axg20202/CNC-parts-and-mods/Docking dust shoe/STL/Left side mount/Main body left.stl

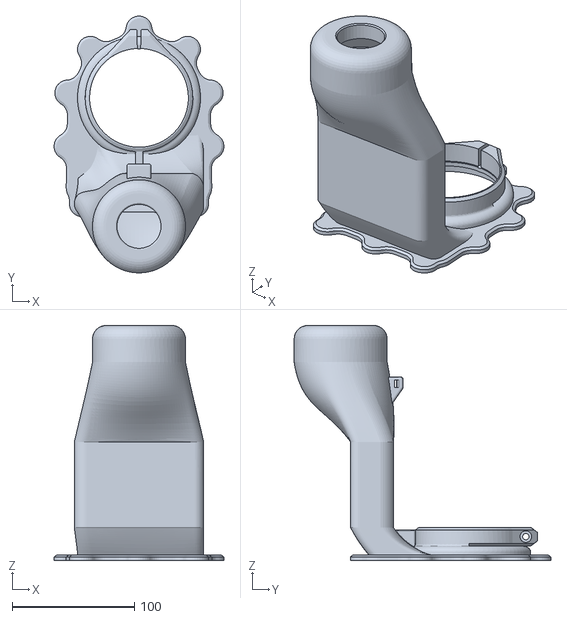
[picture p4: CAD file, 2025-01-09]
Docking dust shoe/STL/Left side mount/Main body left.stl
138.8 x 209.7 x 192.0
