axg20202/CNC-parts-and-mods/Docking dust shoe/STL/Bristle ring.stl

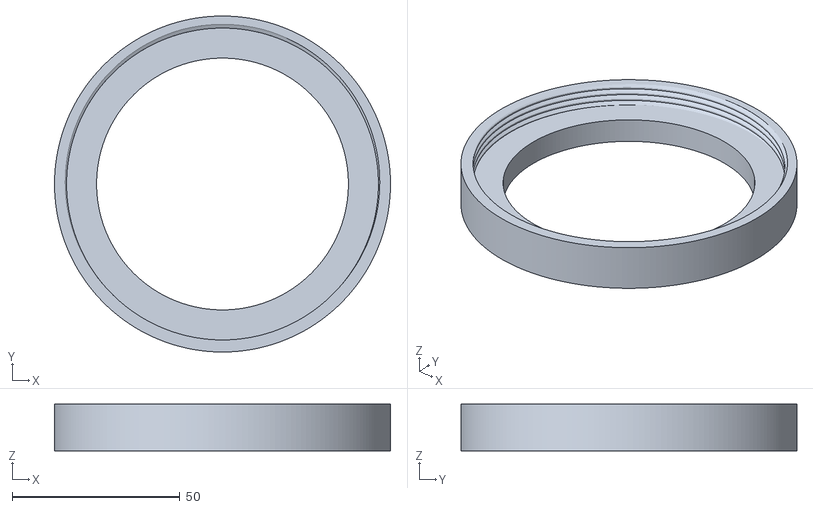
[picture p5: CAD file, 2024-10-30]
Docking dust shoe/STL/Bristle ring.stl
100.2 x 100.2 x 14.0
