axg20202/CNC-parts-and-mods/Docking dust shoe/STL/Right side mount/Brush mount right Z cutout.stl

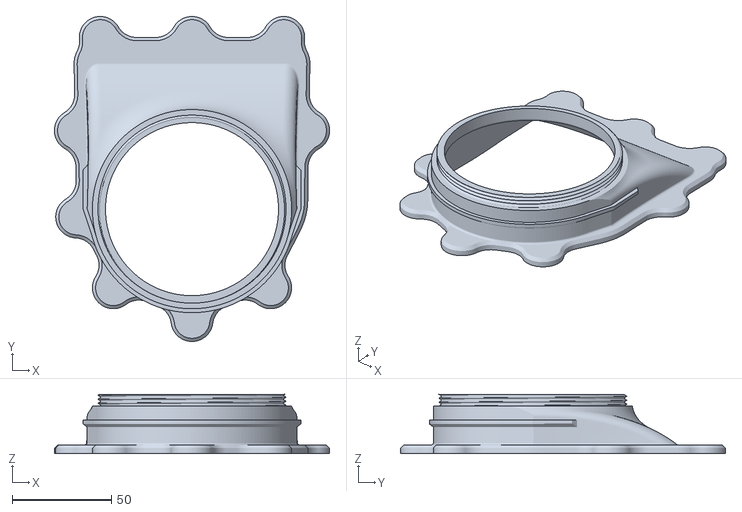
[picture p6: CAD file, 2024-10-30]
Docking dust shoe/STL/Right side mount/Brush mount right Z cutout.stl
138.8 x 164.0 x 30.0
