axg20202/CNC-parts-and-mods/Docking dust shoe/STL/Dock.stl

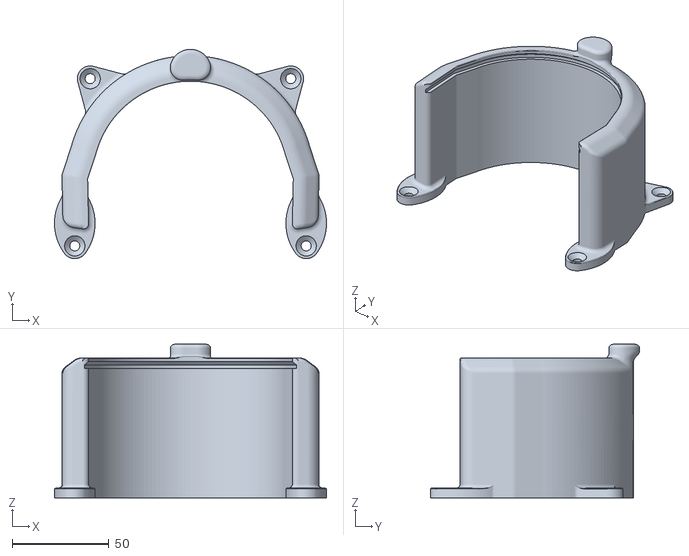
[picture p7: CAD file, 2024-10-30]
Docking dust shoe/STL/Dock.stl
140.9 x 108.4 x 79.6
