axg20202/CNC-parts-and-mods/Docking dust shoe/STL/Spindle brace.stl

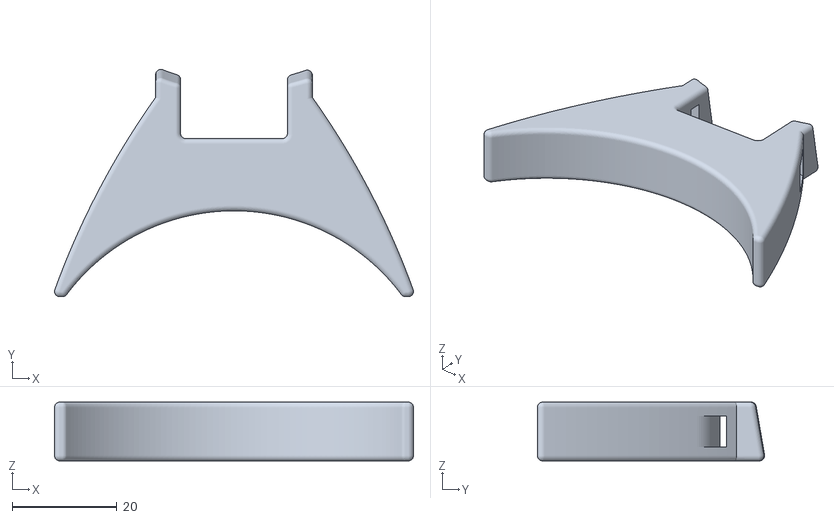
[picture p9: CAD file, 2024-10-30]
Docking dust shoe/STL/Spindle brace.stl
68.7 x 43.5 x 11.2
