axg20202/CNC-parts-and-mods/(list of files, cad)

Other CAD files:
Docking dust shoe/STL/Left side mount/Main body left Z cutout.stl
Docking dust shoe/STL/Left side mount/Brush mount left Z cutout.stl
Docking dust shoe/STL/Left side mount/Brush mount left.stl
