axg20202/CNC-parts-and-mods/(commit log)

2025-01-09 Improved spindle fit tolerance of main body
2025-01-09 Improved spindle fit tolerance
    [Main body left Z cutout.stl]
